VK2ARH/Cowtown-ADX-Project/Gerbers/README.md

The gerber files housed here represent the PCB's used in the latest version of the ADX construction manual v1.6.1
These versions when compared to the original ADX boards:
- improved the aligment the holes on the Top Cover and Main PCB,
- Included the 7 Band identified on the Top Cover Screen Print, together with minor text placement and size adjustments
- Adjusted the footprints, font alignment and naming of the LPF storage on the top cover; and
- enlarged the holes in the power supply socket to enable use of the DC005 power socket.
