VK2ARH/Cowtown-ADX-Project/ADX QUAD BOM Order Details v17.xlsx

Sheet: ADX Orders
This is the main order page - enter details here for each order - (example shown at order 1. ) Put the price of your ADX kit in cell G6 and the cost of each LPF in Cell O6. The sheet will calculate the rest. As payments are made - record them in column S. LPF requirements are trasferred automatically to the LPF details sheet which calculates the number and value of capacitors and toroids required
Buildathon Project #2 - ADX Digital Transceiver
Order Details: at <enter date> |  |  |  |  | Kit Cost | 27.00 | LPF Cost Ea |  |  |  |  |  |  | 3.00
Order # | Name | Callsign | Email | Phone | Member Yes/No | # of ADX Kits | Band Pass Filters |  |  |  |  |  |  |  | Method of Payment | Total Cost | Paid | Owes | ADX Cash Receipts | Donation
 |  |  |  |  |  |  | 80 | 40 | 30 | 20 | 17 | 15 | 10 | Total
1 | Amateur Operator | K1ABC | email@email address | 123 456 78900 | Yes | 1 |  | 1 |  | 1 |  | 1 | 1 | 4 | Cash | $39.00 | $40.00 | $0.00 | $40.00 | $1.00
2 |  |  |  |  |  |  |  |  |  |  |  |  |  | 0 | Check | $0.00 |  | $0.00 | $0.00 | $0.00
3 |  |  |  |  |  |  |  |  |  |  |  |  |  | 0 | Bank | $0.00 |  | $0.00 | $0.00 | $0.00
4 |  |  |  |  |  |  |  |  |  |  |  |  |  | 0 | Paypal | $0.00 |  | $0.00 | $0.00 | $0.00
5 |  |  |  |  |  |  |  |  |  |  |  |  |  | 0 |  | $0.00 |  | $0.00 | $0.00 | $0.00
6 |  |  |  |  |  |  |  |  |  |  |  |  |  | 0 |  | $0.00 |  | $0.00 | $0.00 | $0.00
7 |  |  |  |  |  |  |  |  |  |  |  |  |  | 0 |  | $0.00 |  | $0.00 | $0.00 | $0.00
8 |  |  |  |  |  |  |  |  |  |  |  |  |  | 0 |  | $0.00 |  | $0.00 | $0.00 | $0.00
9 |  |  |  |  |  |  |  |  |  |  |  |  |  | 0 |  | $0.00 |  | $0.00 | $0.00 | $0.00
10 |  |  |  |  |  |  |  |  |  |  |  |  |  | 0 |  | $0.00 |  | $0.00 | $0.00 | $0.00
11 |  |  |  |  |  |  |  |  |  |  |  |  |  | 0 |  | $0.00 |  | $0.00 | $0.00 | $0.00
12 |  |  |  |  |  |  |  |  |  |  |  |  |  | 0 |  | $0.00 |  | $0.00 | $0.00 | $0.00
13 |  |  |  |  |  |  |  |  |  |  |  |  |  | 0 |  | $0.00 |  | $0.00 | $0.00 | $0.00
14 |  |  |  |  |  |  |  |  |  |  |  |  |  | 0 |  | $0.00 |  | $0.00 | $0.00 | $0.00
15 |  |  |  |  |  |  |  |  |  |  |  |  |  | 0 |  | $0.00 |  | $0.00 | $0.00 | $0.00
16 |  |  |  |  |  |  |  |  |  |  |  |  |  | 0 |  | $0.00 |  | $0.00 | $0.00 | $0.00
17 |  |  |  |  |  |  |  |  |  |  |  |  |  | 0 |  | $0.00 |  | $0.00 | $0.00 | $0.00
18 |  |  |  |  |  |  |  |  |  |  |  |  |  | 0 |  | $0.00 |  | $0.00 | $0.00 | $0.00
19 |  |  |  |  |  |  |  |  |  |  |  |  |  | 0 |  | $0.00 |  | $0.00 | $0.00 | $0.00
20 |  |  |  |  |  |  |  |  |  |  |  |  |  | 0 |  | $0.00 |  | $0.00 | $0.00 | $0.00
21 |  |  |  |  |  |  |  |  |  |  |  |  |  | 0 |  | $0.00 |  | $0.00 | $0.00 | $0.00
22 |  |  |  |  |  |  |  |  |  |  |  |  |  | 0 |  | $0.00 |  | $0.00 | $0.00 | $0.00
23 |  |  |  |  |  |  |  |  |  |  |  |  |  | 0 |  | $0.00 |  | $0.00 | $0.00 | $0.00
24 |  |  |  |  |  |  |  |  |  |  |  |  |  | 0 |  | $0.00 |  | $0.00 | $0.00 | $0.00
25 |  |  |  |  |  |  |  |  |  |  |  |  |  | 0 |  | $0.00 |  | $0.00 | $0.00 | $0.00
26 |  |  |  |  |  |  |  |  |  |  |  |  |  | 0 |  | $0.00 |  | $0.00 | $0.00 | $0.00
27 |  |  |  |  |  |  |  |  |  |  |  |  |  | 0 |  | $0.00 |  | $0.00 | $0.00 | $0.00
28 |  |  |  |  |  |  |  |  |  |  |  |  |  | 0 |  | $0.00 |  | $0.00 | $0.00 | $0.00
29 |  |  |  |  |  |  |  |  |  |  |  |  |  | 0 |  | $0.00 |  | $0.00 | $0.00 | $0.00
30 |  |  |  |  |  |  |  |  |  |  |  |  |  | 0 |  | $0.00 |  | $0.00 | $0.00 | $0.00
Total |  |  |  |  |  | 1 | 0 | 1 | 0 | 1 | 0 | 1 | 1 | 4 |  | $39.00 | $40.00 | $0.00 | $40.00 | $1.00
 |  |  |  |  |  |  |  |  |  |  | Total LPF's Inc. 10m in Kit |  |  | 4

Sheet: ADX QUAD BOM
This sheet calculates the components needed to complete the number of kits required. The number of kits (cell N5) is taken from the number of kit orders received on the ADX orders page. The Cowtown Club has no affiliation with the sellers of these products, this is just a list of where we found the products to purchase - there are many other sources available but we found that ordering all orders at the same time from Ali Express, often saved on freight or had the freight service upgraded at no extra cost resulting in earlier delivery. We chose to order the cheaper ceramic capacitors and they worked fine.
Component | Designator | Footprint |  | QTY |  | Total | Ordered or to order | AvailableIn Stock | Shortfall | Cost inc Shipping and Tax | Due Date | In stock / Delivered | Still to arrive | Order From | Part No / Reference
 |  |  |  | Total | Checked | 1
100uF/16V | C1,C16,C24 | Capacitor_THT:CP_Radial_D5.0mm_P2.50mm | 3 | 24 |  | 3 | 3 |  | 0 | 0.00 | 0 | 0 | 3 | Ali | 100pcs 16v100uf 5x7mm Aluminum Electrolytic Capacitors 100uf16v 16v 100uf 100mf 100mfd 16v100mf 100mf16v 16v100mfd - Capacitors - AliExpress (https://www.aliexpress.us/item/3256802302936362.html?curPageLogUid=3u8Q4GoTaQCj)
10uF/16V | C13,C18 | Capacitor_THT:CP_Radial_D5.0mm_P2.50mm | 2 |  |  | 2 | 2 |  |  |  |  | 0 | 2 | Amazon | 100pcs 16v100uf 5x7mm Aluminum Electrolytic Capacitors 100uf16v 16v 100uf 100mf 100mfd 16v100mf 100mf16v 16v100mfd - Capacitors - AliExpress (https://www.aliexpress.us/item/3256802302936362.html?curPageLogUid=3u8Q4GoTaQCj)
620pF (680pF) | C11 | Capacitor_THT:C_Disc_D3.0mm_W1.6mm_P2.50mm (520pF/680pF OK) | 1 |  |  | 1 | 1 |  |  |  |  | 0 | 1 | Ali | 100pcs Ceramic Capacitor 50v 1pf ~ 100nf 0.1uf 104 4.7pf 10pf 22pf 33pf 47pf 100pf 101 220pf 10nf 330pf 470pf 1nf 103 47nf 473 - Capacitors - AliExpress (https://www.aliexpress.us/item/3256801649549581.html?curPageLogUid=6d2mjc9N4ton) |  | `
100nF | C2,C3,C6,C8,C9,C10,C14,C15,C19,C20,C21,C22,C23 | Capacitor_THT:C_Disc_D3.0mm_W1.6mm_P2.50mm | 13 |  |  | 13 | 13 |  |  |  |  | 0 | 0 | Ali | 100pcs Ceramic Capacitor 50v 1pf ~ 100nf 0.1uf 104 4.7pf 10pf 22pf 33pf 47pf 100pf 101 220pf 10nf 330pf 470pf 1nf 103 47nf 473 - Capacitors - AliExpress (https://www.aliexpress.us/item/3256801649549581.html?mp=1&_randl_shipto=US)
10nF | C4,C5,C4,C5 | Capacitor_THT:C_Disc_D3.0mm_W1.6mm_P2.50mm | 4 |  |  | 4 | 4 |  |  |  |  | 0 | 4 | Ali | 100pcs Ceramic Capacitor 50v 1pf ~ 100nf 0.1uf 104 4.7pf 10pf 22pf 33pf 47pf 100pf 101 220pf 10nf 330pf 470pf 1nf 103 47nf 473 - Capacitors - AliExpress (https://www.aliexpress.us/item/3256801649549581.html?curPageLogUid=6d2mjc9N4ton)
470nF | C7 | Capacitor_THT:C_Disc_D3.0mm_W1.6mm_P2.50mm | 1 |  |  | 1 | 1 |  |  |  |  | 0 | 1 | Ali | 100pcs Ceramic Capacitor 50v 1pf ~ 100nf 0.1uf 104 4.7pf 10pf 22pf 33pf 47pf 100pf 101 220pf 10nf 330pf 470pf 1nf 103 47nf 473 - Capacitors - AliExpress (https://www.aliexpress.us/item/3256801649549581.html?curPageLogUid=6d2mjc9N4ton)
SPK. Mic | CON1 CON2 | digikey-footprints:Headphone_Jack_3.5mm_SJ1-3523N | 2 | 2 |  | 2 | 2 |  |  |  |  | 0 | 10 | Ali & Amazon | 10pcs 3 Pin 3.5mm Audio Jack Socket Pcb Panel Mount For Headphone With Nut Pj-324m - Connectors - AliExpress (https://www.aliexpress.us/item/2251832685563184.html?mp=1&_randl_shipto=US)
LED TX | D1 | LED_THT:LED_D3.0mm RED | 1 | 1 |  | 1 | 1 |  |  |  |  | 0 | 1 | Ali | 5mm Led Red Yellow Green Blue White Orange Light Emitting Diode Free Shipping 100pcs/lot - Diodes - AliExpress (https://www.aliexpress.us/item/2251801020227199.html?mp=1&_randl_shipto=US)
LED FT8, FT4,JS8,WSPR | D2,D3, D4, D5 | LED_THT:LED_D3.0mm GREEN | 4 | 4 |  | 4 | 4 |  |  |  |  | 0 | 4 |  | 5mm Led Red Yellow Green Blue White Orange Light Emitting Diode Free Shipping 100pcs/lot - Diodes - AliExpress (https://www.aliexpress.us/item/2251801020227199.html?mp=1&_randl_shipto=US)
1N4148 | D6 D7 D8 | Diode_THT:D_A-405_P2.54mm_Vertical_AnodeUp | 3 | 3 |  | 3 | 3 |  |  |  |  | 0 | 3 | Ali | HOT SELL 100 PCS 1N4148 DO 35 IN4148 Switching Diode FREE SHIPPMENT|Integrated Circuits| - AliExpress (https://www.aliexpress.us/item/2251832473773777.html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)
1N5817 | D9 | Diode_THT:D_A-405_P2.54mm_Vertical_KathodeUp | 1 | 1 |  | 1 | 1 |  |  |  |  | 0 | 1 | Ali | 50pcs 1n5817 1n5819 1n5399 1n4937 1n4004 Schottky Rectifier Diode 1n4001 1n4007 Uf4007 Her107 Fr207 Fr157 Fr107 Rl207 Do-41 - Diodes - AliExpress (https://www.aliexpress.us/item/3256801365779334.html?curPageLogUid=63h3NCkzxPtI)
1N4756 | PA Protection Diode | Diode_THT:D_A-405_P2.54mm_Vertical_KathodeUp | 1 | 1 |  | 1 | 1 |  |  |  |  | 0 | 1 | Ali | 50pcs 1n4756 47v Zener Diode 1w (1n4754 39v - Diodes - AliExpress (https://www.aliexpress.us/item/2251800878318489.html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)
BNC | J1A1 | Connector_Coaxial:BNC_Amphenol_B6252HB-NPP3G-50_Horizontal | 1 | 1 |  | 1 | 1 |  |  |  |  | 0 | 0 | Ali | 12/50/100pcs BNC Female Right Angle Panel Mount Plastic Type White PC Board PCB With Nut bulkhead Connector|Connectors| - AliExpress (https://www.aliexpress.us/item/2251832816537976.html?_randl_shipto=US)
PJ-102A (PJ-102AH Preferred) | J2 | digikey-footprints:Barrel_Jack_5.5mmODx2.1mmID_PJ-102A | 1 | 1 |  | 1 | 1 |  |  |  |  | 0 | 0 | Mouser | 50pcs CUI PJ-102AH Power Barrel Connector Jack 2mm ID 5.5mm OD 24VDC 5A R/A T/H | eBay (https://www.ebay.com/itm/204204054469)
5.5 x 2.1mm DC Plug | Extra | For incomming power lead | 1 | 1 |  | 1 | 1 |  |  |  |  | 0 | 1 | Ali | 50pcs 9mm 2.1mm x 5.5mm DC Male Power Plug Jack Connector Laptop - AliExpress (https://www.aliexpress.us/item/2251832530777400.html)
1uH | L1 | Inductor_THT:L_Toroid_Vertical_L10.0mm_W5.0mm_P5.08mm | 1 | 1 |  | 1 | 1 |  |  |  |  | 0 | 1 | Ali | Inductor 100 Mh | Inductance 1 Mh | Inductance 470 | Power Inductor | Ring Inductors - 50pcs - Aliexpress (https://www.aliexpress.us/item/3256804648661440.html?scm_id=1007.40000.326746.0&scm-url=1007.40000.326746.0)
100uH | L2 | Resistor_THT:R_Axial_DIN0204_L3.6mm_D1.6mm_P2.54mm_Vertical | 1 | 1 |  | 1 | 1 |  |  |  |  | 0 | 1 | Ali | 50PCS Color ring inductor 0510 100UH (101K) 1W in line inductor| | - AliExpress (https://www.aliexpress.us/item/3256804268602096.html?curPageLogUid=ow41Wd5ic4YT)
BS170 | Q1,Q2,Q3, Q4 | Package_TO_SOT_THT:TO-92_HandSolder | 4 | 4 |  | 4 | 4 |  |  |  |  | 0 | 0 | Mouser | BS170-D27Z onsemi / Fairchild | Mouser (https://www.mouser.com/ProductDetail/onsemi-Fairchild/BS170-D27Z?qs=0lQeLiL1qybtYouixLcZzA%3D%3D)
1M | R1 | Resistor_THT:R_Axial_DIN0204_L3.6mm_D1.6mm_P1.90mm_Vertical | 1 | 16 |  | 1 | 1 |  |  |  |  | 0 | 1 | Ali | 600pcs 1/4w 1% 20pcs 30values Metal Film Resistor Assortment Kit Set Pack Electronic Diy Kit Resistor - Resistors - AliExpress (https://www.aliexpress.us/item/2255801088812240.html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)
2.7k | R12 | Resistor_THT:R_Axial_DIN0204_L3.6mm_D1.6mm_P1.90mm_Vertical | 1 |  |  | 1 | 1 |  |  |  |  | 0 | 1
100 | R14 | Resistor_THT:R_Axial_DIN0204_L3.6mm_D1.6mm_P1.90mm_Vertical | 1 |  |  | 1 | 1 |  |  |  |  | 0 | 1
4.7k | R2 | Resistor_THT:R_Axial_DIN0204_L3.6mm_D1.6mm_P1.90mm_Vertical | 1 |  |  | 1 | 1 |  |  |  |  | 0 | 1
10k | R3,R4,R10,R11,R15,R16,R17 | Resistor_THT:R_Axial_DIN0204_L3.6mm_D1.6mm_P1.90mm_Vertical | 7 |  |  | 7 | 7 |  |  |  |  | 0 | 0 | Ali | 100pcs/lot 1/4w 0r~20m 1% Metal Film Resistor 100r 220r 1k 1.5k 2.2k 4.7k 10k 22k 47k 100k 100 220 1k5 2k2 4k7 Ohm - Motor Driver - AliExpress (https://www.aliexpress.us/item/2255800393877179.html?mp=1&_randl_shipto=US)
1k | R5,R6,R7,R8,R9,R13 | Resistor_THT:R_Axial_DIN0204_L3.6mm_D1.6mm_P1.90mm_Vertical | 6 |  |  | 6 | 6 |  |  |  |  | 0 | 0 | Ali | 100pcs/lot 1/4w 0r~20m 1% Metal Film Resistor 100r 220r 1k 1.5k 2.2k 4.7k 10k 22k 47k 100k 100 220 1k5 2k2 4k7 Ohm - Motor Driver - AliExpress (https://www.aliexpress.us/item/2255800393877179.html?mp=1&_randl_shipto=US)
UP(BAND) | SW1 | Button_Switch_THT:SW_PUSH_6mm | 3 | 3 |  | 3 | 3 |  |  |  |  | 0 | 0 | Amazon | Taiss/100 Pcs 6 x 6mm x 9mm PCB Momentary Tactile Tact Push Button Switch 4 Pin DIP (Black): Amazon.com: Industrial & Scientific (https://www.amazon.com/dp/B0796P9RQC?psc=1&smid=A2VILSBUHD1UD8&ref_=chk_typ_imgToDp)
DOWN(CAL) | SW2 | Button_Switch_THT:SW_PUSH_6mm |  |  |  |  | 0 |  |  |  |  | 0
TX | SW3 | Button_Switch_THT:SW_PUSH_6mm |  |  |  |  | 0 |  |  |  |  | 0
CD2003GB_GP | U1 | Package_DIP:DIP-16_W7.62mm_Socket_LongPads | 1 | 1 |  | 1 | 1 |  |  |  |  | 0 | 1 | Ali | 10pcs/lot Cd2003gp Dip16 Cd 2003 Gp Fm/am Radio Ic Cd2003g P Cd2003 2003gp - Motor Driver - AliExpress (https://www.aliexpress.us/item/3256802245743374.html?_randl_shipto=US)
16 Pin DIP Socket | U1a |  | 1 | 1 |  | 1 | 1 |  |  |  |  | 0 | 1 | Ali | 66pcs/lot Dip Ic Sockets Adaptor Solder Type Socket Kit 6 8 14 16 18 20 24 28 Pin Dip-8 16-pins Dip8 Dip16 Ic Connector - Integrated Circuits - AliExpress (https://www.aliexpress.us/item/2251832647707462.html?_randl_shipto=US)
SI5351_Module | U2 | VFO_footprint:SI5351 Module_Vertical | 1 | 1 |  | 1 | 1 |  |  |  |  | 0 | 0 | Ali | DC 3V 5V CJMCU 5351 Si5351A Si5351 I2C Clock Generator Breakout Board Module Signal Generator Clock 8KHz 160MHz For Arduino|Integrated Circuits| - AliExpress (https://www.aliexpress.us/item/2255799881061297.html?mp=1&_randl_shipto=US)
SN74ACT244N | U3 | Package_DIP:DIP-20_W7.62mm_LongPads | 1 | 1 |  | 1 | 1 |  |  |  |  | 0 | 0 | Mouser | SN74ACT244NE4 Texas Instruments | Mouser (https://www.mouser.com/ProductDetail/Texas-Instruments/SN74ACT244NE4?qs=pdM4geFiyZRQL1nKqTZ0%252BA%3D%3D)
20 Pin DIP Socket | U3a |  | 1 | 1 |  | 1 | 1 |  |  |  |  | 0 | 0 | Ali | 66PCS/Lot DIP IC Sockets Adaptor Solder Type Socket Kit 6 8 14 16 18 20 24 28 Pin DIP-8 16-Pins DIP8 DIP16 IC Connector - AliExpress (https://www.aliexpress.us/item/2251832647707462.html)
Arduino Nano | U4 | Arduino Nano with Bootloader | 1 | 1 |  | 1 | 1 |  |  |  |  | 0 | 5 | Ali | Mini / Type C / Micro USB Nano 3.0 With the bootloader compatible Nano controller for arduino CH340 USB driver 16Mhz ATMEGA328P| | - AliExpress (https://www.aliexpress.us/item/3256805181470394.html?mp=1&_randl_shipto=US)
Pin Header Strip 40 pin - Female | For LPF Boards = set Male/Fema;le | Arduino:Arduino_Nano - Pin Headers 40 pin Strip Female | 1 | 2 |  | 1 | 1 |  |  |  |  | 0 | 0 | Ali | 20pcs 10 pairs 40 Pin 1x40 Single Row Male and Female 2.54 Breakable Pin Header PCB JST Connector Strip for Arduino Black|Connectors| - AliExpress (https://www.aliexpress.us/item/2251832538163556.html?curPageLogUid=YJny2n8w01yP)
Arduino_Nano_Socket - Female | U4a Pin Header Strip Female 40 pin | Required to house LPF | 1 |  |  | 1 | 1 |  |  |  |  | 0 | 1 | Ali | Single Row Female Header | Female Header Connector | Pin Female Connector - 20pcs 40pin - Aliexpress (https://www.aliexpress.us/item/2251832416528370.html?curPageLogUid=kArDyA7HB4sT&_randl_shipto=US)
Pin Header Male 40 pin | For LPF's only 20 pin needed |  | 0.1 |  |  | 0.1 | 0.1 |  |  |  |  | 0 | 0.1 |  | Will balance pins between the two orders
Mounting Spacers | 6mm |  | 4 | 4 |  | 4 | 4 |  |  |  |  | 0 | 0 | Ali | https://www.aliexpress.us/item/3256804465136887.html?curPageLogUid=hvmFJ1G9Zhkm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
Mounting Spacers | 16.5mm (Buy 18mm?) |  | 4 |  |  | 4 | 4 |  |  |  |  | 0 | 0 |  | https://www.aliexpress.us/item/2251832684795919.html?mp=1&_randl_shipto=US
M3 18mm Stainless Machine Screw | For Mounting Kit Includes 50 x M2.5 /M3 |  | 4 | 4 |  | 4 | 4 |  |  |  |  | 0 | 0 | Ali | https://www.aliexpress.us/item/2251832785290389.html?_randl_shipto=US
M3 8mm Stainless Machine Screw | For Mounting Kit Includes 50 x M2.5 / M3 |  | 4 |  |  | 4 | 4 |  |  |  |  | 0 | 0 | Ali | https://www.aliexpress.us/item/2251832785290389.html?_randl_shipto=US
Main Board ADX |  |  | 1 | 1 |  | 1 | 1 |  |  |  |  | 0 | 1 | JLCPCB | https://jlcpcb.com
Upper Cover |  |  | 1 | 1 |  | 1 | 1 |  |  |  |  | 0 | 1
Lower Cover |  |  | 1 | 1 |  | 1 | 1 |  |  |  |  | 0 | 1
LPF Board |  | Qty varies with orders received, value taken from LPF Details tab | - | - |  | 4 | 4 |  |  |  |  | 0 | 4
26awg magnet wire | approx 4' per LPF set |  | 4 | 1 |  | 4 | 4 |  |  |  |  | 0 | 4 | Amazon | BNTECHGO 26 AWG Magnet Wire - Enameled Copper Wire - Enameled Magnet Winding Wire - 4 oz - 0.0157" Diameter 1 Spool Coil Red Temperature Rating 155℃ Widely Used for Transformers Inductors: Amazon.com: Industrial & Scientific (https://www.amazon.com/dp/B07DYHHMYH?ref=ppx_yo2ov_dt_b_product_details&th=1)
T37-2 | Select T37-2 for <=20m Select T37-6 for > 20m (10m with kit) |  | 2 | 0 |  | 4 | 4 |  |  |  |  | 0 | 4 | Kits and Parts | https://www.jpmsupply.com/T37-2-Toroid-Core-Powdered-Iron-p/38017.htm https://kitsandparts.com/toroids.php | Much cheaper to buy in bulk
T37-6 Use for 10m LPF |  |  |  | 2 |  | 4 | 4 |  |  |  |  | 0 | 4
FT37-43 |  |  | 1 | 4 |  | 4 | 4 |  |  |  |  | 0 | 0 | Mouser | 5943000201 Fair-Rite | Mouser (https://www.mouser.com/ProductDetail/623-5943000201)
Caps for LPF | Various Values 0805 100v COD |  | 7 | 7 |  | 26 | 26 |  |  |  |  | 0 | 26 | Mouser | Various values - see LPF Sheet
Solder Paste for LPF Boards |  |  | 2 | 2 |  | 1 | 1 |  |  |  |  | 0 |  | Amazon | https://a.co/d/i794pOU
Pin Headers - Male 2 x 4 pin | For each LPF - included in above | Required for each LPF (Enough in Main Board) | 0 | 1 |  | 0 | 0 |  |  |  |  | 0 | 0 |  | Included above (row 41)
Plastic Bags | For assembly of kits |  | 1 | 1 |  | 1 | 1 |  |  |  |  | 0 | 1 | Local Supermarket
Anti Static Bags | To protect Static Sesitive Components |  | 1 | 1 |  | 1 | 1 |  |  |  |  | 0 | 1 | Amazon | Amazon.com: Ellbest 100pcs Antistatic Bags, Resealable Ziplock ESD Shielding Bags 3.15x5.12 inch Anti Static for HDD SDD Electronic Device : Electronics (https://www.amazon.com/gp/product/B07QK2NSDQ/ref=ppx_yo_dt_b_asin_title_o04_s00?ie=UTF8&th=1)
Pill Bags" | For each LPF Kit & Kit components |  | 5 | 5 |  | 5 | 5 |  |  |  |  | 0 | 5 | Amazon | Amazon.com: CURRAVAX Pill Bags Pack of 500 - BPA Free 3 x 2.75 inch Pill Pouch - Reusable Pill Pouches for Medicine with Write on Label –Clear Ziplock Pill Baggies for Travel Medicine Organizer : Health & Household (https://www.amazon.com/gp/product/B09SBL4TP2/ref=ppx_yo_dt_b_asin_title_o04_s00?ie=UTF8&th=1)
Silicon Feet | For base of ADX | Nice to have | 4 | 4 |  | 4 | 4 |  |  |  |  | 0 | 4 | Amazon | Amazon.com: 192Pack Clear Cabinet Door Bumpers, 1/2‘’ Diameter Rubber Bumpers Self Adhesive, Widely Used in Drawer Bumpers, Cabinet Stoppers, Glass Tops, Picture Frames, Kitchen Furniture Dampening Noise : Everything Else (https://www.amazon.com/gp/product/B0BFHTGKNM/ref=ppx_od_dt_b_asin_title_s00?ie=UTF8&th=1)
Additional Shipping Cost |  |  |  |  |  |  |  |  |  |  |  | 0 | 0
 | Net of Project Cost |  |  |  |  |  |  |  | 0 |  |  |  | 0
 |  |  |  |  |  |  |  |  | 0 |  |  |  | 0
 |  |  | 121.1 |  |  | Total Project Cost |  |  |  | 0.00

Sheet: LPF Details
This sheet caclulates the value and number of capacitors along with the number of toroids required to supply the LPF's ordered on the main ADX Orders sheet. It also lists the Mouser part numbers for the SMD capacitors. Other sources are available, but this will get you started. We found it difficult to order THD 100v capacitors that were small enough to fit onto the LPF's and ended up using SMD's and soldering them to the boards before assembling the kits. The soldering was done using a hot flow plate - lots of work, so if you can find THD capacitors much easire on the project organiser :) As a suggestion you may wish to supply the kits with a standard set of LPF's - this would avoid a lot of the logistics and kitting challenges with individuals ordering different LPF's.
 |  |  | Band | C1 | C2 | C3 | C4 | C5 | C6 | C7 | L1 | L2 | L3
 |  |  | 80 | 660pf | 1000pf | 1000pf | 2000 pf | 620pf | 2000pf | 100nF | 19Turn/T37-2 | 14 Turn/T37-2 | 20Turn/FT37-43
 |  |  | 40 | 130pf | 470pf | 470pf | 1000pf | 300pf | 1000pf | 100nF | 15Turn/T37-2 | 10Turn/T37-2 | 20Turn/FT37-43
 |  |  | 30 | 100pf | 330pf | 330pf | 660pf | 220pf | 660pf | 100nF | 12Turn/T37-2 | 8Turn/T37-2 | 20Turn/FT37-43
 |  |  | 20 | 68pf | 470pf |  | 470pf | 150pf | 470pf | 100nF | 10Turn/T37-2 | 7Turn/T37-2 | 20Turn/FT37-43
 |  |  | 17 | 91pF | 180pF | 180pF | 360pF | 120pF | 360pF | 100nF | 11Turn/T37-6 | 7Turn/T37-6 | 20Turn/FT37-43
 |  |  | 15 | 68pF | 300pF | 15pF | 300pf | 100pF | 300pF | 100nF | 11Turn/T37-6 | 7Turn/T37-6 | 20Turn/FT37-43
 |  |  | 10 | 39pF | 240pF |  | 240pF | 75pF | 240pF | 100nF | 9Turn/T37-6 | 6Turn/T37-6 | 20Turn/FT37-43
 |  |  | Band | Capacitors (pf) 100v |  |  |  |  |  |  |  |  |  |  |  |  |  |  |  |  |  |  |  |  |  | Inductors
 |  |  |  | 15 | 39 | 68 | 75 | 91 | 100 | 120 | 130 | 150 | 180 | 220 | 240 | 300 | 330 | 360 | 470 | 620 | 660 | 1000 | 2000 use 2 x 1000 | 100nF | Total | T37-2 | T37-6 | FT37-43
 |  |  | Mouser SMD # | 08051A150JAT2A | 08051A390JAT2A | CL21C680JC61PNC | C0805C750J1GAC7800 | GQM2195G2E910JB12D | C0805C101JAGAC7800 | CL21C121JDCNNNC | 08051A131JAT2A | 08051A151JAT2A | C0805C181J2GAC7800 | 08052A221JAT2A | VJ0805D241KXPAJ | 08051A301FAT2A | 08051A331JAT2A | C0805C361J1GAC7800 | C0805C471K1RAC7800 | C0805C621J2GAC7800 | 08051A661FAT2A | C2012C0G2A102J060AA | GRM2165C2A202JA01D
 |  |  | 80 |  |  |  |  |  |  |  |  |  |  |  |  |  |  |  |  | 1 | 1 | 6 | 0 | 1 | 9 | 2 |  | 1
 |  |  | 40 |  |  |  |  |  |  |  | 1 |  |  |  |  | 1 |  |  | 2 |  |  | 2 |  | 1 | 7 | 2 |  | 1
 |  |  | 30 |  |  |  |  |  | 1 |  |  |  |  | 1 |  |  | 2 |  |  |  | 2 |  |  | 1 | 7 | 2 |  | 1
 |  |  | 20 |  |  | 1 |  |  |  |  |  | 1 |  |  |  |  |  |  | 3 |  |  |  |  | 1 | 6 | 2 |  | 1
 |  |  | 17 |  |  |  |  | 1 |  | 1 |  |  | 2 |  |  |  |  | 2 |  |  |  |  |  | 1 | 7 | - | 2 | 1
 |  |  | 15 | 1 |  | 1 |  |  | 1 |  |  |  |  |  |  | 3 |  |  |  |  |  |  |  | 1 | 7 | - | 2 | 1
 |  |  | 10 |  | 1 |  | 1 |  |  |  |  |  |  |  | 3 |  |  |  |  |  |  |  |  | 1 | 6 | - | 2 | 1
 |  |  | Total | 1 | 1 | 2 | 1 | 1 | 2 | 1 | 1 | 1 | 2 | 1 | 3 | 4 | 2 | 2 | 5 | 1 | 3 | 8 | 0 | 7 | 49 | 8 | 6 | 7
 |  |  |  |  |  |  |  |  |  |  |  |  |  |  |  |  |  |  |  |  |  |  |  |  |  | #REF! | #REF! | 10m Filter
Band | Total Orders | Spare | Total LPF's | Capacitors (pf) 100v |  |  |  |  |  |  |  |  |  |  |  |  |  |  |  |  |  |  |  |  |  | Inductors
 |  |  |  | 15 | 39 | 68 | 75 | 91 | 100 | 120 | 130 | 150 | 180 | 220 | 240 | 300 | 330 | 360 | 470 | 620 | 660 (680) | 1000 | 2000 use 2 x 1000 | 100nF | Total LPF's | T37-2 | T37-6 | FT37-43
80 | 0 | 0 | 0 | 0 | 0 | 0 | 0 | 0 | 0 | 0 | 0 | 0 | 0 | 0 | 0 | 0 | 0 | 0 | 0 | 0 | 0 | 0 | 0 | 0 | 0 | 0 |  | 0
40 | 1 | 0 | 1 | 0 | 0 | 0 | 0 | 0 | 0 | 0 | 1 | 0 | 0 | 0 | 0 | 1 | 0 | 0 | 2 | 0 | 0 | 2 | 0 | 1 | 1 | 2 |  | 1
30 | 0 | 0 | 0 | 0 | 0 | 0 | 0 | 0 | 0 | 0 | 0 | 0 | 0 | 0 | 0 | 0 | 0 | 0 | 0 | 0 | 0 | 0 | 0 | 0 | 0 | 0 |  | 0
20 | 1 | 0 | 1 | 0 | 0 | 1 | 0 | 0 | 0 | 0 | 0 | 1 | 0 | 0 | 0 | 0 | 0 | 0 | 3 | 0 | 0 | 0 | 0 | 1 | 1 | 2 |  | 1
17 | 0 | 0 | 0 | 0 | 0 | 0 | 0 | 0 | 0 | 0 | 0 | 0 | 0 | 0 | 0 | 0 | 0 | 0 | 0 | 0 | 0 | 0 | 0 | 0 | 0 |  | 0 | 0
15 | 1 | 0 | 1 | 1 | 0 | 1 | 0 | 0 | 1 | 0 | 0 | 0 | 0 | 0 | 0 | 3 | 0 | 0 | 0 | 0 | 0 | 0 | 0 | 1 | 1 |  | 2 | 1
10 | 1 | 0 | 1 | 0 | 1 | 0 | 1 | 0 | 0 | 0 | 0 | 0 | 0 | 0 | 3 | 0 | 0 | 0 | 0 | 0 | 0 | 0 | 0 | 1 | 1 |  | 2 | 1
Total | 4 | 0 | 4 | 1 | 1 | 2 | 1 | 0 | 1 | 0 | 1 | 1 | 0 | 0 | 3 | 4 | 0 | 0 | 5 | 0 | 0 | 2 | 0 | 4 | 4 | 4 | 4 | 4
 |  |  | Capacitor | Number Reqired |  | sense check
 |  |  | 15 | 1 |  | Band | Total LPF's | No of Capacitors Required for each band | Total Number of Capacitors
 |  |  | 39 | 1
 |  |  | 68 | 2 |  | 80 | 0 | 9 | 0
 |  |  | 75 | 1 |  | 40 | 1 | 7 | 7
 |  |  | 91 | 0 |  | 30 | 0 | 7 | 0
 |  |  | 100 | 1 |  | 20 | 1 | 6 | 6
 |  |  | 120 | 0 |  | 17 | 0 | 7 | 0
 |  |  | 130 | 1 |  | 15 | 1 | 7 | 7
 |  |  | 150 | 1 |  | 10 | 1 | 6 | 6
 |  |  | 180 | 0 |  | Total | 4 | 49 | 26
 |  |  | 220 | 0
 |  |  | 240 | 3 |  |  | 4
 |  |  | 300 | 4
 |  |  | 330 | 0
 |  |  | 360 | 0
 |  |  | 470 | 5
 |  |  | 620 | 0
 |  |  | 680 | 0
 |  |  | 1000 | 2
 |  |  | 2000 | 0
 |  |  | 100nF | 4
 |  |  |  | 26

Sheet: LPF Build and Kitting List
This sheet assists with the LPF kitting requirements based on orders detailed on the ADX Orders tab. Including length of magnet wire required to wind the toroids. Can be used as a check sheet when assembling the LPF kits. Make all entries on the ADX Orders tab and calculated details will flow through to here.
Buildathon Project #2 - ADX Digital Transceiver
LPF Kitting
Order # | Name | Callsign | Member | ADX Kits | Band Pass Filters |  |  |  |  |  |  |  | Toroids |  |  |  | Magnet Wire | Check | Still to Pay
 |  |  |  |  | 80 | 40 | 30 | 20 | 17 | 15 | 10 | Total | Red T37-2 | Yellow T37-6 | Silver T37-43 | Total | Length
Magnet wire" for each band |  |  |  |  | 29.5 | 25.5 | 23 | 21.5 | 22 | 22 | 20.5
1 | Amateur Operator | K1ABC | Yes | 1 | 0 | 1 | 0 | 1 | 0 | 1 | 1 | 4 | 4 | 4 | 4 | 12 | 101.5 |  | $0.00
2 | 0 | 0 | 0 | 0 | 0 | 0 | 0 | 0 | 0 | 0 | 0 | 0 | 0 | 0 | 0 | 0 | 12 |  | $0.00 |  | L1 | Mag Wire" | L2 | Mag Wire" | L3 | Mag Wire" | Total Mag Wire
3 | 0 | 0 | 0 | 0 | 0 | 0 | 0 | 0 | 0 | 0 | 0 | 0 | 0 | 0 | 0 | 0 | 12 |  | $0.00 | 80 | 19Turn/T37-2 | 10.5 | 14 Turn/T37-2 | 8 | 20Turn/FT37-43 | 11 | 29.5
4 | 0 | 0 | 0 | 0 | 0 | 0 | 0 | 0 | 0 | 0 | 0 | 0 | 0 | 0 | 0 | 0 | 12 |  | $0.00 | 40 | 15Turn/T37-2 | 8.5 | 10Turn/T37-2 | 6 | 20Turn/FT37-43 | 11 | 25.5
5 | 0 | 0 | 0 | 0 | 0 | 0 | 0 | 0 | 0 | 0 | 0 | 0 | 0 | 0 | 0 | 0 | 12 |  | $0.00 | 30 | 12Turn/T37-2 | 7 | 8Turn/T37-2 | 5 | 20Turn/FT37-43 | 11 | 23
6 | 0 | 0 | 0 | 0 | 0 | 0 | 0 | 0 | 0 | 0 | 0 | 0 | 0 | 0 | 0 | 0 | 12 |  | $0.00 | 20 | 10Turn/T37-2 | 6 | 7Turn/T37-2 | 4.5 | 20Turn/FT37-43 | 11 | 21.5
7 | 0 | 0 | 0 | 0 | 0 | 0 | 0 | 0 | 0 | 0 | 0 | 0 | 0 | 0 | 0 | 0 | 12 |  | $0.00 | 17 | 11Turn/T37-6 | 6.5 | 7Turn/T37-6 | 4.5 | 20Turn/FT37-43 | 11 | 22
8 | 0 | 0 | 0 | 0 | 0 | 0 | 0 | 0 | 0 | 0 | 0 | 0 | 0 | 0 | 0 | 0 | 12 |  | $0.00 | 15 | 11Turn/T37-6 | 6.5 | 7Turn/T37-6 | 4.5 | 20Turn/FT37-43 | 11 | 22
9 | 0 | 0 | 0 | 0 | 0 | 0 | 0 | 0 | 0 | 0 | 0 | 0 | 0 | 0 | 0 | 0 | 12 |  | $0.00 | 10 | 9Turn/T37-6 | 5.5 | 6Turn/T37-6 | 4 | 20Turn/FT37-43 | 11 | 20.5
10 | 0 | 0 | 0 | 0 | 0 | 0 | 0 | 0 | 0 | 0 | 0 | 0 | 0 | 0 | 0 | 0 | 12 |  | $0.00
11 | 0 | 0 | 0 | 0 | 0 | 0 | 0 | 0 | 0 | 0 | 0 | 0 | 0 | 0 | 0 | 0 | 12 |  | $0.00
12 | 0 | 0 | 0 | 0 | 0 | 0 | 0 | 0 | 0 | 0 | 0 | 0 | 0 | 0 | 0 | 0 | 12 |  | $0.00
13 | 0 | 0 | 0 | 0 | 0 | 0 | 0 | 0 | 0 | 0 | 0 | 0 | 0 | 0 | 0 | 0 | 12 |  | $0.00
14 | 0 | 0 | 0 | 0 | 0 | 0 | 0 | 0 | 0 | 0 | 0 | 0 | 0 | 0 | 0 | 0 | 12 |  | $0.00
15 | 0 | 0 | 0 | 0 | 0 | 0 | 0 | 0 | 0 | 0 | 0 | 0 | 0 | 0 | 0 | 0 | 12 |  | $0.00
16 | 0 | 0 | 0 | 0 | 0 | 0 | 0 | 0 | 0 | 0 | 0 | 0 | 0 | 0 | 0 | 0 | 12 |  | $0.00
17 | 0 | 0 | 0 | 0 | 0 | 0 | 0 | 0 | 0 | 0 | 0 | 0 | 0 | 0 | 0 | 0 | 12 |  | $0.00
18 | 0 | 0 | 0 | 0 | 0 | 0 | 0 | 0 | 0 | 0 | 0 | 0 | 0 | 0 | 0 | 0 | 12 |  | $0.00
19 | 0 | 0 | 0 | 0 | 0 | 0 | 0 | 0 | 0 | 0 | 0 | 0 | 0 | 0 | 0 | 0 | 12 |  | $0.00
20 | 0 | 0 | 0 | 0 | 0 | 0 | 0 | 0 | 0 | 0 | 0 | 0 | 0 | 0 | 0 | 0 | 12 |  | $0.00
21 | 0 | 0 | 0 | 0 | 0 | 0 | 0 | 0 | 0 | 0 | 0 | 0 | 0 | 0 | 0 | 0 | 12 |  | $0.00
22 | 0 | 0 | 0 | 0 | 0 | 0 | 0 | 0 | 0 | 0 | 0 | 0 | 0 | 0 | 0 | 0 | 12 |  | $0.00
23 | 0 | 0 | 0 | 0 | 0 | 0 | 0 | 0 | 0 | 0 | 0 | 0 | 0 | 0 | 0 | 0 | 12 |  | $0.00
24 | 0 | 0 | 0 | 0 | 0 | 0 | 0 | 0 | 0 | 0 | 0 | 0 | 0 | 0 | 0 | 0 | 12 |  | $0.00
25 | 0 | 0 | 0 | 0 | 0 | 0 | 0 | 0 | 0 | 0 | 0 | 0 | 0 | 0 | 0 | 0 | 12 |  | $0.00
26 | 0 | 0 | 0 | 0 | 0 | 0 | 0 | 0 | 0 | 0 | 0 | 0 | 0 | 0 | 0 | 0 | 12 |  | $0.00
27 | 0 | 0 | 0 | 0 | 0 | 0 | 0 | 0 | 0 | 0 | 0 | 0 | 0 | 0 | 0 | 0 | 12 |  | $0.00
28 | 0 | 0 | 0 | 0 | 0 | 0 | 0 | 0 | 0 | 0 | 0 | 0 | 0 | 0 | 0 | 0 | 12 |  | $0.00
29 | 0 | 0 | 0 | 0 | 0 | 0 | 0 | 0 | 0 | 0 | 0 | 0 | 0 | 0 | 0 | 0 | 12 |  | $0.00
30 | 0 | 0 | 0 | 0 | 0 | 0 | 0 | 0 | 0 | 0 | 0 | 0 | 0 | 0 | 0 | 0 | 12 |  | $0.00
Total |  |  |  | 1 | 0 | 1 | 0 | 1 | 0 | 1 | 1 |  | 4 | 4 | 4 | 12 | 449.5
 |  |  |  |  |  |  |  |  |  |  |  |  |  |  |  |  | 37.45833333

Sheet: KIT BOM & Checklist
Sub Component Bag | Part | Designator | Qty
 |  |  |  | For use as a checklist when assembling the kits
Capacitors & Ceramic Filter | 100uF/16V | C1,C16,C24 | 3
 | 10uF/16V | C13,C18 | 2
 | 620pF (680pF) 681 | C11 | 1
 | 100nF 104 | C2,C3,C6,C8,C9,C10,C14,C15,C19,C20,C21,C22,C23 | 13
 | 10nF 103 | C4,C5,C4,C5 | 4
 | 470nF 474 | C7 | 1
 | Self Adhesive Silicon Pads | For use on bottom of completed ADX | 4
Diodes & Inductors | LED TX | D1 (Red) | 1
 | LED FT8, FT4,JS8,WSPR | D2,D3, D4, D5 (Green) | 4
 | 1uH | L1 | 1
 | 100uH | L2 | 1
 | 1N4148 | D6 D7 D8 | 3
 | 1N5817 | D9 | 1
 | 1N4756 | PA Protection Diode | 1
Connectors and Switches | BNC | J1A1 | 1
 | PJ-102A (PJ-102AH Preferred) | J2 | 1
 | SPK. Mic | CON1 CON2 | 2
 | 5.5 x 2.1mm DC Plug | Extra | 1
 | UP(BAND) | SW1 | 3
 | DOWN(CAL) | SW2
 | TX | SW3
 | 16 Pin DIP Socket | U1a | 1
 | 20 Pin DIP Socket | U3a | 1
Static Sensitive Devices | BS170 | Q1,Q2,Q3, Q4 | 4
 | CD2003GB_GP | U1 | 1
 | SN74ACT244N | U3 | 1
 | SI5351_Module | U2 | 1
 | Arduino Nano | XA1 | 1
Resistors | 1M | R1 | 1
 | 2.7k (2.2K and 510R to be used in series) | R12 | 1
 | 100 | R14 | 1
 | 4.7k | R2 | 1
 | 10k | R3,R4,R10,R11,R15,R16,R17 | 7
 | 1k | R5,R6,R7,R8,R9,R13 | 6
Hardware | Pin Header Female | One 40 pin strip supplied - builder to cut into 2 x 15 pin strips (Nano) and 1 x 7 pin socket for Si5351. | 1
 | Pin Header Male 4 pin | PCB LPF Socket | Qty
 | Mounting Spacers | 6mm | 4
 | Mounting Spacers | 18mm | 4
 | M3 18mm Stainless Machine Screw |  | 4
 | M3 8mm Stainless Machine Screw |  | 4
 | Silicon Feet |  | 4
PCB's | Main Board ADX |  | 1
 | Upper Cover |  | 1
 | Lower Cover |  | 1
LPF Kits See LPF Kitting List Unique per Order | LPF Board | Include one Spare LPF Board with each kit | Qty
 | 26awg magnet wire | Qty varies depending upon chosen bands | Qty
 | T37-2 | 2 with each LPF <= 20m | Qty
 | T37-6 Use for 10m LPF | 2 with each LPF >= 17m
 | FT37-43 | 1 for each LPF
 | Pin Headers - Male & Female 4 Pin | One set for each LPF (to be cut from 40pin strips) | Qty
