VK2ARH/Cowtown-ADX-Project/Fine Tuning the ADX.pdf

## Fine Tuning the ADX

The tuning of the ADX during construcon (see page 19 of the Cowtown ADX Construcon Manual) established the operaon of the Si5351 by monitoring the output of CAL test point and adjusng to establish a 1MHz square wave.
When built you may wish to conduct further fine calibraon. There are several ways to do this, but I have found the following technique the easiest to perform if you have access to a spectrum scope on a radio or SDR receiver. In this example I am using the spectrum scope on the Icom 7300 to perform the calibraon, but any spectrum scope that you trust the frequency reading can be used.
Setup
Set up the ADX with the correct band/LPF combinaon and connect it to WSJT-X. ‘Warm up’ the ADX for about 2-3 minutes to allow the VFO to stabilize. Aached a dummy load to the ADX and posioned an ‘antenna’ next to the dummy load. I used a short VHF whip antenna connected to the IC7300 in order not to overdrive the receiver, but a piece of wire connected to the receiver antenna input would work just as well. Schemacally the setup is shown below:

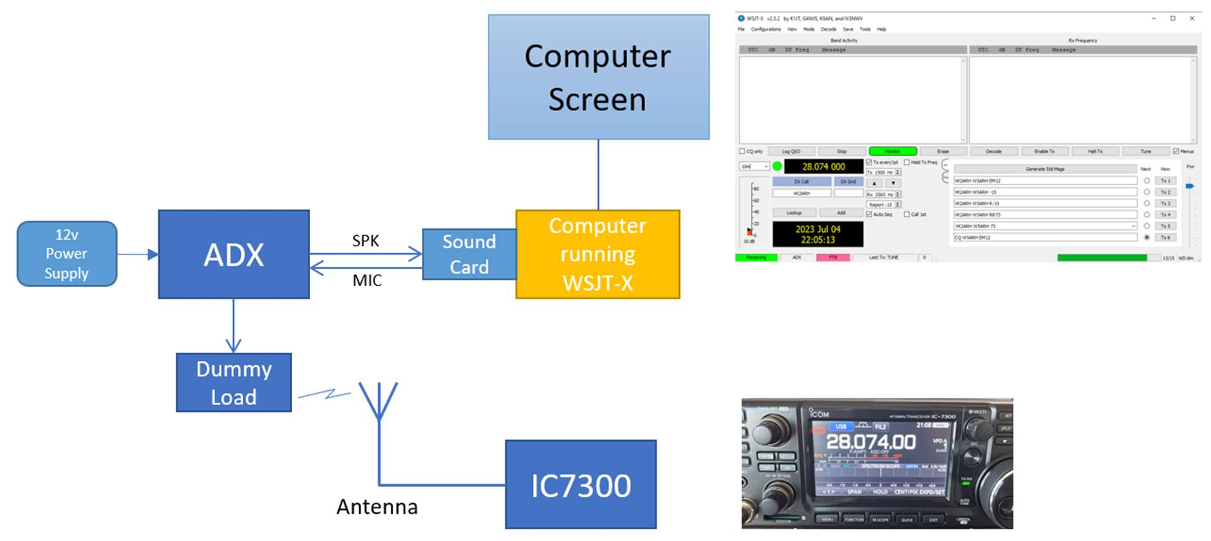
[picture p1: figure]

The actual setup I used is shown below:

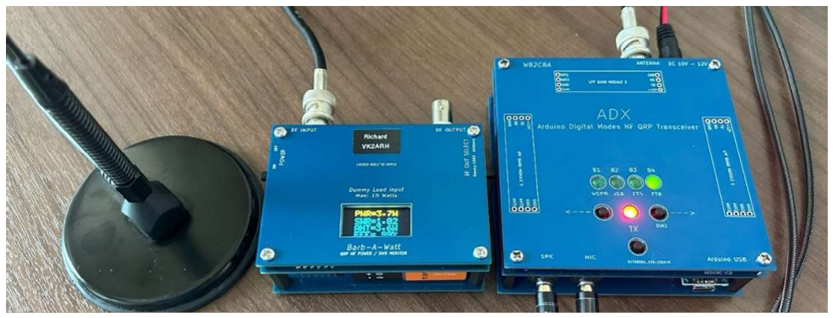
[picture p2: figure]

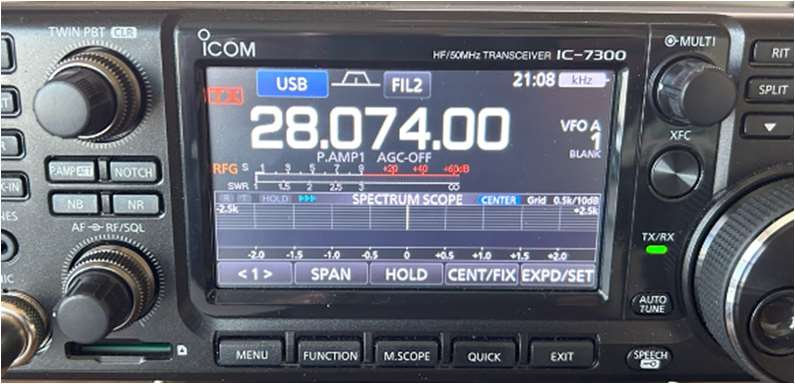
[picture p3: figure]

Set the receiver to 28.074 MHz with the spectrum scope span set to 2.5KHz. Set the ADX to FT8 Mode (when powered up hit to le or right buon to change mode). Once tuned to 28.074 MHz all other bands will be tuned, and there should be no need for any further tuning. Configure WSJT-X to Tx with a 1500 Hz tone:

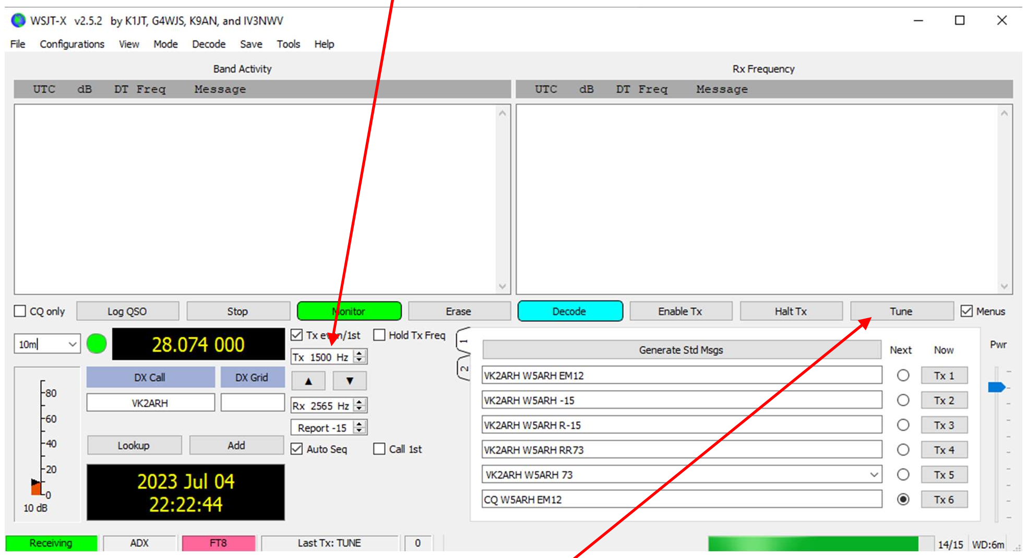
[picture p4: figure]

Acvate the Tune funcon of WSJT-X by pressing the ‘Tune’ buon. The buon
should turn red and your ADX will transmit a 1500 Hz tone on the selected
frequency. Press the ‘Tune’ buon again when you wish to stop transming.
The 1500 Hz tone is in the middle of the transmied ‘sideband’ so the output should appear in the middle of the band scope display (‘0’ offset). You should see a signal detected on the spectrum scope ‘waterfall’ as shown below. Adjust the tuning dial so that the observed signal is in the center of the scope and read the Tx frequency offset:

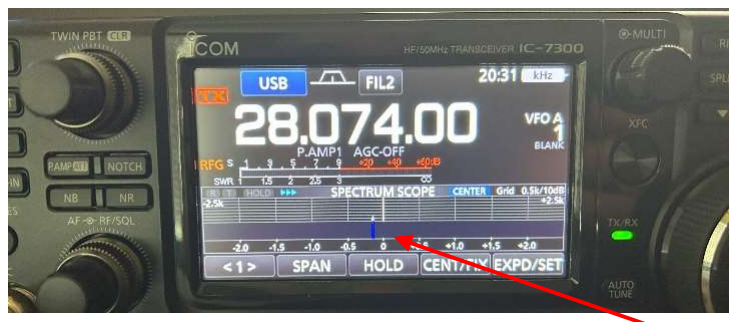
[picture p5: figure]
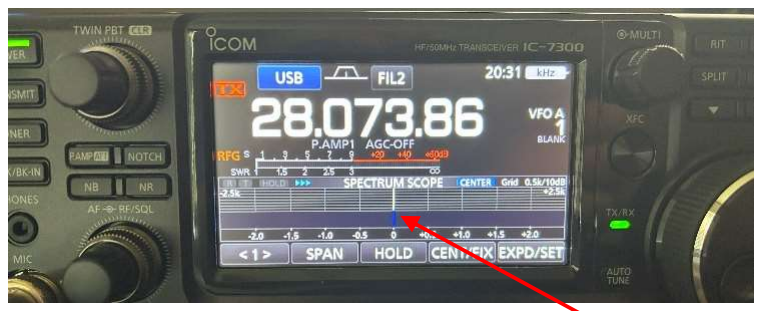
[picture p6: figure]

In this case the observed signal is a lile below the ‘0’ point and adjusng the tuning dial to center the signal shows that the transmied signal is 28.073.86 MHz, 140Hz lower than the desired frequency of 28.074.00 MHz. Your Tx frequency will most likely be a lile different from this example.

Stop the transmission by pressing the Tune buon again in WSJT-X (the buon should turn grey) and record the Tx frequency. If an adjustment is required adjust the frequency as follows:
Place the ADX into Calibraon Mode:
- Power down the ADX
- Hold down the right hand ‘CAL’ buon and keep it held down whist you power up the ADX. The TX LED will flash briefly, and the currently selected band LED will flash three mes - followed by the FT8 and WSPR LED’s flashing four mes simultaneously and they will then remain illuminated indicang that you are in Calibraon Mode. Release the CAL buon when the FT8 and WSPR lights are flashing before they permanently illuminate.
Adjust the output frequency:
- You will need to press the le and right buons many mes to adjust the frequency. Start by pressing the buon at least 20 mes in quick succession.
o To increase the frequency repeatedly press the LEFT buon.
o To decrease the frequency repeatedly press the RIGHT buon.
- To store the adjustment, briefly press (a short press) the TX buon. The TX LED flashes three mes indicang that the calibraon adjustment has been saved. The WSPR and FT8 LED’s will remain illuminated.
- To exit Calibraon Mode – power down the ADX.
Test the output frequency:
- Power up the ADX and wait for the Band Indicator LED to flash and the FT8 LED to illuminate.
- Acvate the tune funcon again and observe the new Tx frequency on the spectrum scope.
- Determine the movement that has occurred as a result of the calibraon, and if necessary, repeat the calibraon procedure adjusng the number of buon presses proporonally with the amount of frequency adjustment required. Do not be surprised if you need to press the buon 100 mes or more to move the Tx frequency in larger increments. You will likely have to repeat the process several mes.

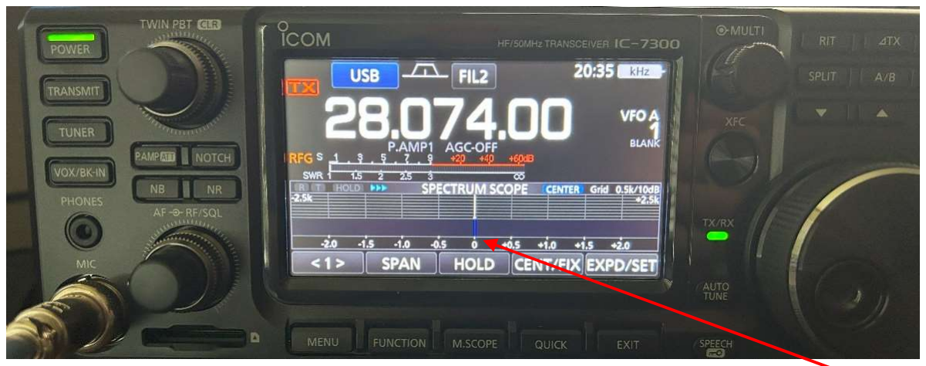
[picture p7: figure]

Ulmately you are looking for the FT8 transmied signal with a 1500 Hz tone to appear in the middle of the spectrum scope, confirming that the ADX is accurately tuned.
Good Luck
