VK2ARH/Cowtown-ADX-Project/Blank LPF Testing Spread Sheet.xlsx

Test | Band | Vin | Tx Current No LPF mA | Non PA Pwr (W) | TX Current (mA) | Pout W | Tx Pin W | Eff % | Heat Loss (W) | Changes Made
1 | 40 | 12 | 72 | 0.864 | 340 | 2.6 | 3.216 | 80.85 | 0.616 | Base state with even L2 windings
2 | 40 | 12 | 72 | 0.864 | 320 | 2.2 | 2.976 | 73.92 | 0.776 | record changes made here eg: expanded L2 windings to Max Spacing
3 | 40 | 12 | 72 | 0.864 |  | 3.5 | -0.864 | -405.09 | -4.364
4 | 40 | 12 | 72 | 0.864 |  | 3.5 | -0.864 | -405.09 | -4.364
5 | 40 | 12 | 72 | 0.864 |  | 3.2 | -0.864 | -370.37 | -4.064
6 | 40 | 12 | 72 | 0.864 |  | 3.2 | -0.864 | -370.37 | -4.064
7 | 40 | 12 | 72 | 0.864 |  | 3.2 | -0.864 | -370.37 | -4.064
8 | 40 | 12 | 72 | 0.864 |  | 3.2 | -0.864 | -370.37 | -4.064
9 | 40 | 12 | 72 | 0.864 |  | 3.2 | -0.864 | -370.37 | -4.064
10 | 40 | 12 | 72 | 0.864 |  | 3.2 | -0.864 | -370.37 | -4.064
 | Value | Enter your observed values in these cells |  |  |  |  |  |  | Tx Efficiency above 70%
 |  |  |  |  |  |  |  |  |  | Heat loss suitable for WSPR without additional cooling (less than 1.5W
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
