VK2ARH/Cowtown-ADX-Project/(commit log)

2023-08-04 Add files via upload
    This file contains all the worksheets necessary to record orders, calculate the number of LPF and mainboard components required to build the number of kits required. The sheet contains four tabs:
    - ADX Orders: Here you enter the details for each kit ordered
    - ADX Quad BOM: This sheet calculates the number of individual componts (by value) required to build the number of required kits as well as providing a worksheet to manage and record the orders placed, expected delivery date and number received. The sheet also provides the list of vendors where the Cowtown project purchased the components for their build.
    - LPF Details: This tab calculates the number and value of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
    [ADX QUAD BOM Order Details v17.xlsx]
2024-07-14 Update README.md
    Added details of 3D Printed enclosure designed by Simon Mitchell VK2YU
2024-12-16 Add files via upload
    Blank spreadsheet for collecting data whilst adjusting LPF's for maximum performance
    [Blank LPF Testing Spread Sheet.xlsx]
2024-12-17 Add files via upload
    Instructions for tuning your LPF's for maximum power and efficiency
2024-12-22 Update README.md
    Updated link to 3D printed enclosure.
2025-03-09 Create Gerber Files for PCBs
    This folder houses the Gerber Files for the ADX Boards outlined in V1.6 of the Construction Manual
2025-03-09 Create README.md
    Folder created to house most recent Gerber files for the ADX PCB's identified in the latest construction manual.
